Pieterpolini/opendbc/canduino/pcb/pcb_bottom_V002.png

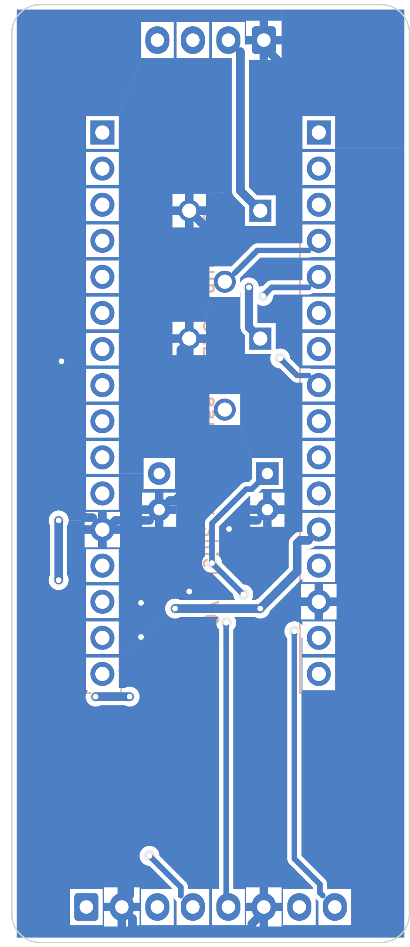
canduino/pcb/pcb_bottom_V002.png
