Pieterpolini/opendbc/canduino/pcb/pcb_bottom_V003.png

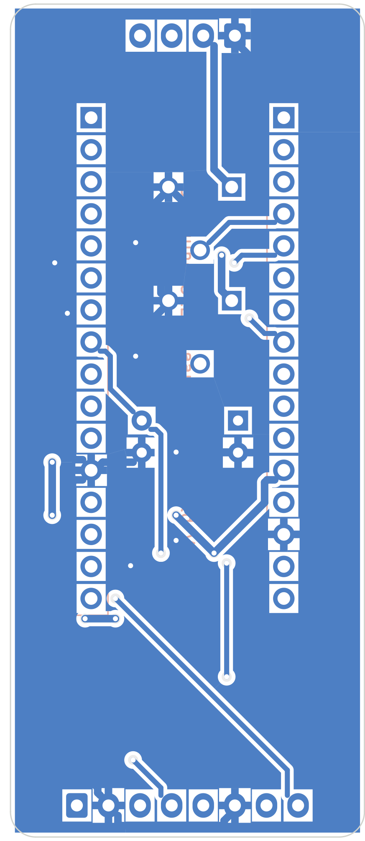
canduino/pcb/pcb_bottom_V003.png
