Pieterpolini/opendbc/canduino/pcb/pcb_top_V002.png

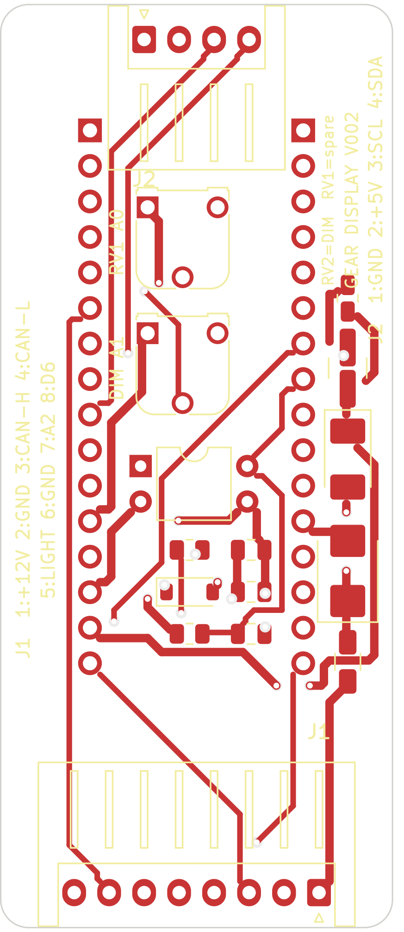
canduino/pcb/pcb_top_V002.png
