Pieterpolini/opendbc/canduino/pcb/pcb_top_V003.png

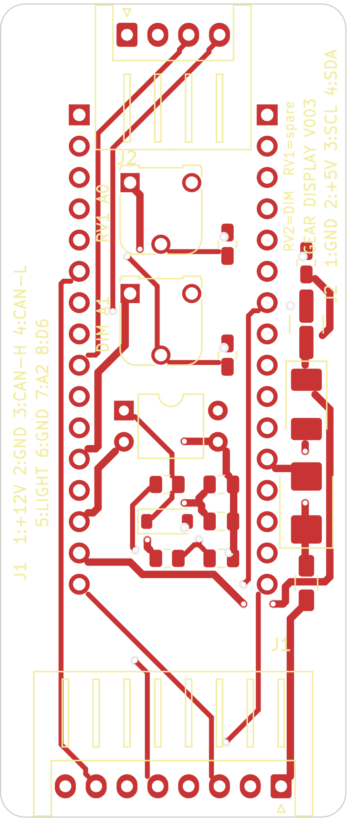
canduino/pcb/pcb_top_V003.png
