Pieterpolini/opendbc/canduino/pcb/pcb_top_V005.png

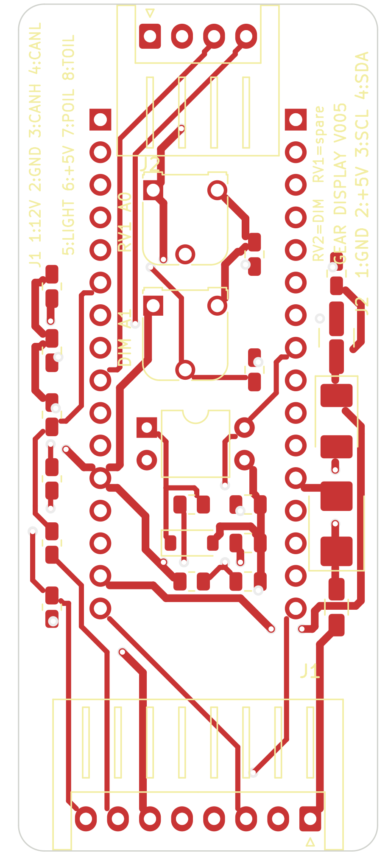
canduino/pcb/pcb_top_V005.png
