Pieterpolini/opendbc/canduino/pcb/pcb_top_V006.png

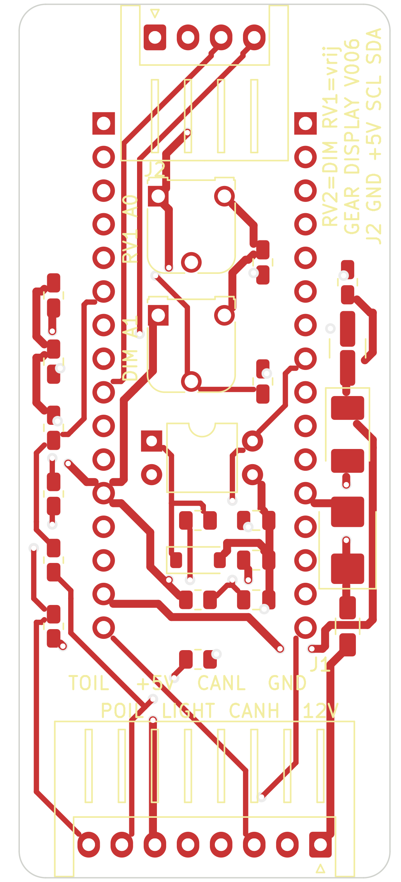
canduino/pcb/pcb_top_V006.png
