Pieterpolini/opendbc/canduino/pcb/bom_V006_jlc.csv

Comment | Designator | Footprint | LCSC Part #
3k3 | R1 | R_0805_2012Metric
10k | R2 | R_0805_2012Metric
1k8 | R3 | R_0805_2012Metric
4k7 | R4,R5 | R_0805_2012Metric
100k | R6 | R_0805_2012Metric
10uF/50V | C1 | C_1210_3225Metric
100nF/50V | C2 | C_0805_2012Metric
100nF | C3,C6,C7,C8,C9,C10 | C_0805_2012Metric
10uF | C4 | C_0805_2012Metric
1uF | C5 | C_0805_2012Metric
SS34 | D1 | D_SMA
SMBJ24A pin1=K | D2 | D_SMB
1N4148W | D3 | D_SOD-123
0.5A PTC | F1 | Fuse_1206_3216Metric
