Pieterpolini/opendbc/canduino/pcb/schematic_V006.pdf

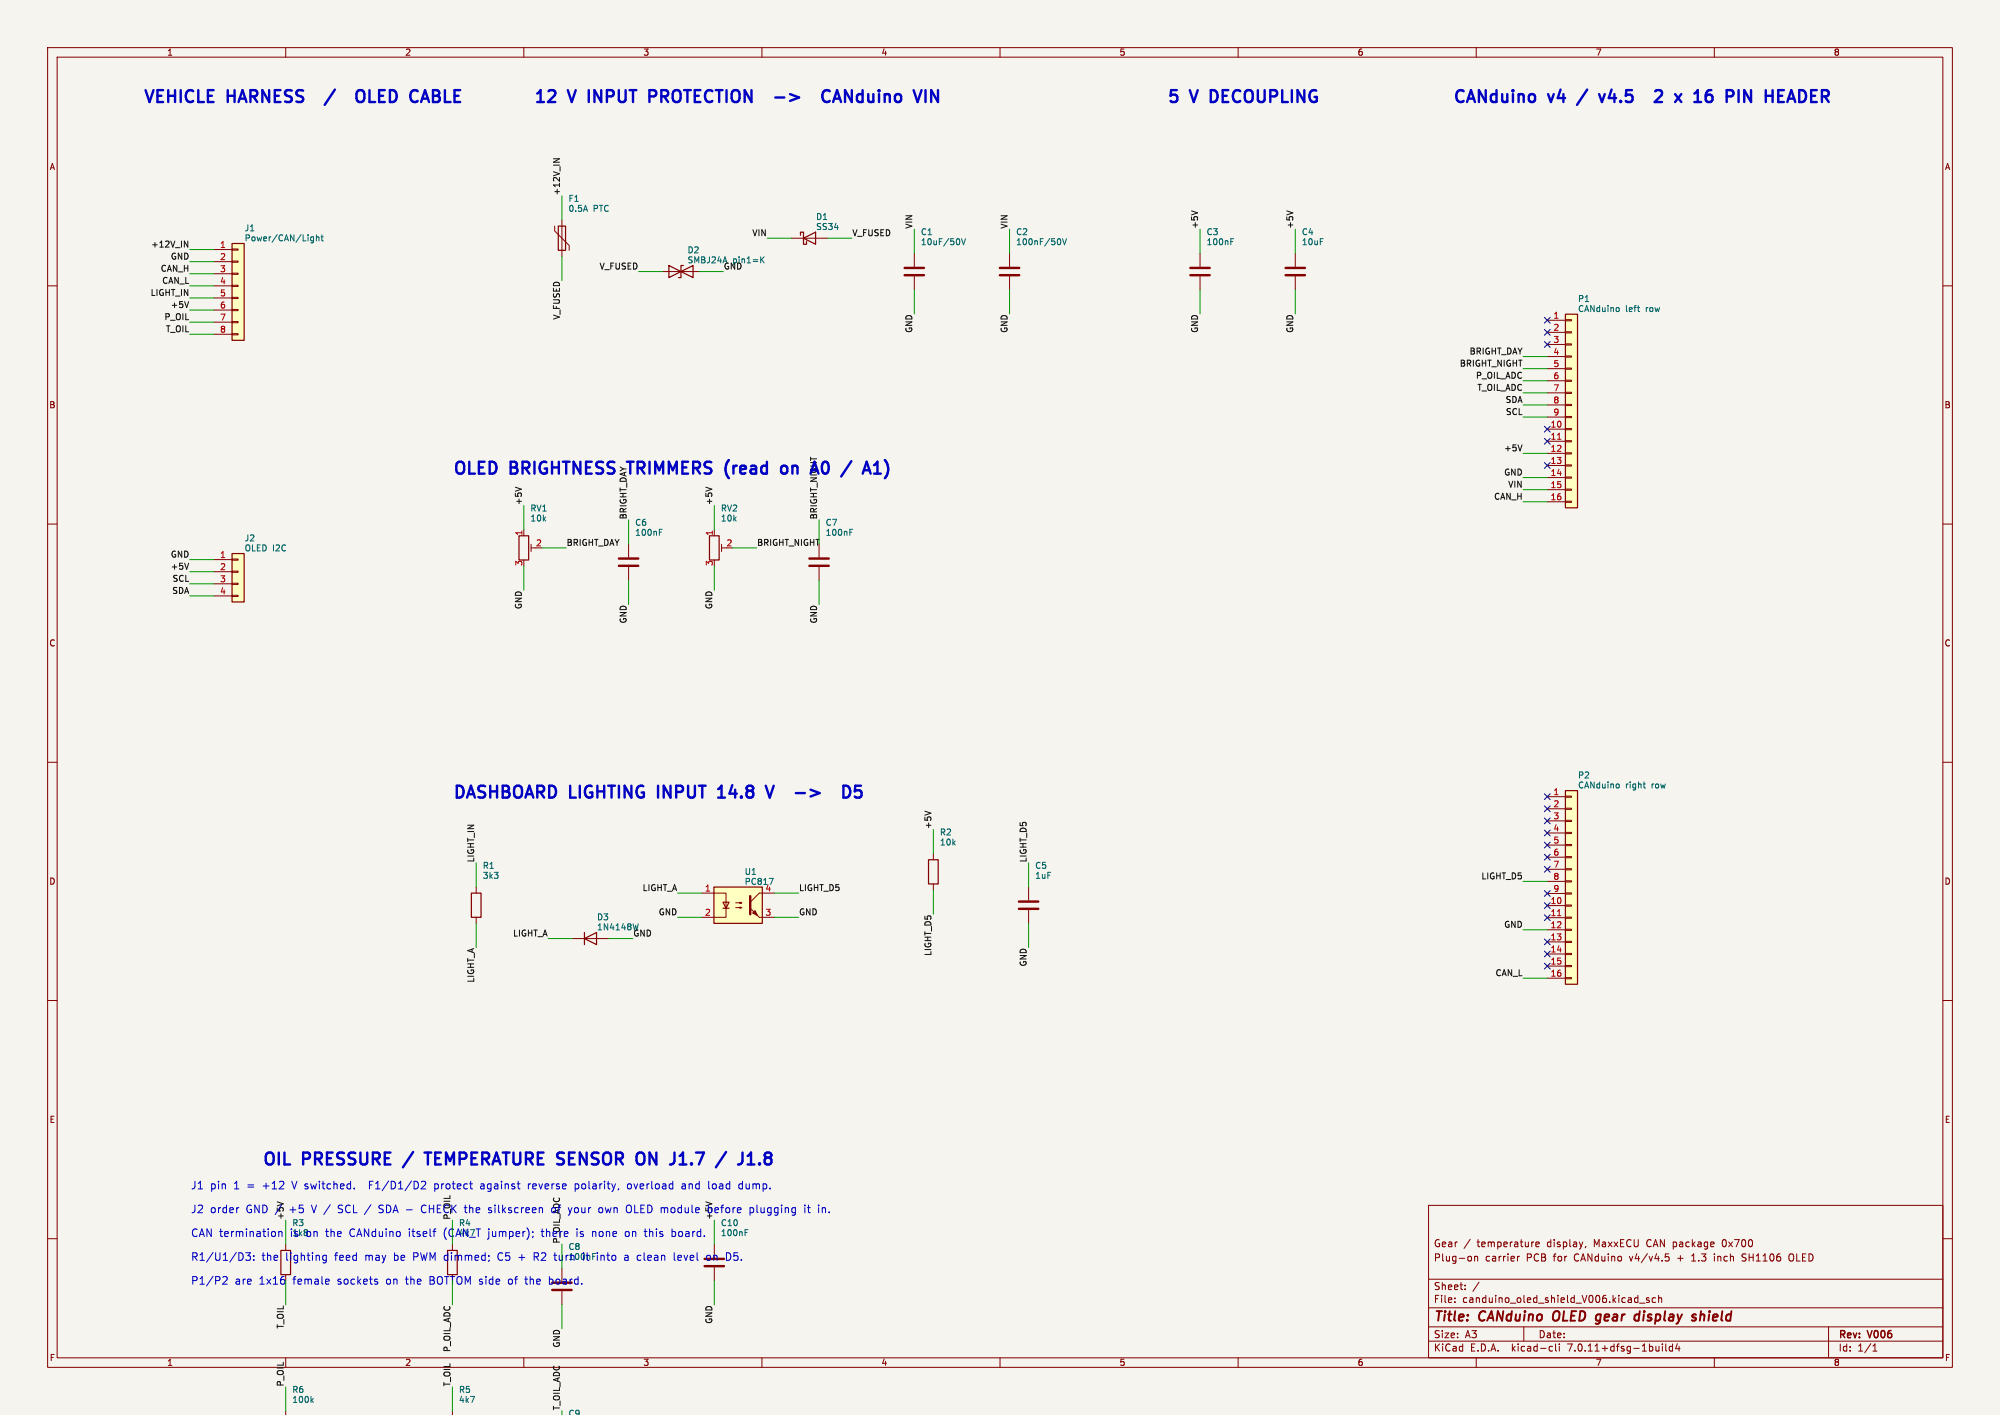
[picture p7: page 1]

OLED BRIGHTNESS TRIMMERS (read on A0 / A1)

OIL PRESSURE / TEMPERATURE SENSOR ON J1.7 / J1.8

Id: 1/1 Title: CANduino OLED gear display shield
