Pieterpolini/opendbc/canduino/pcb/pcb_bottom_V006.pdf

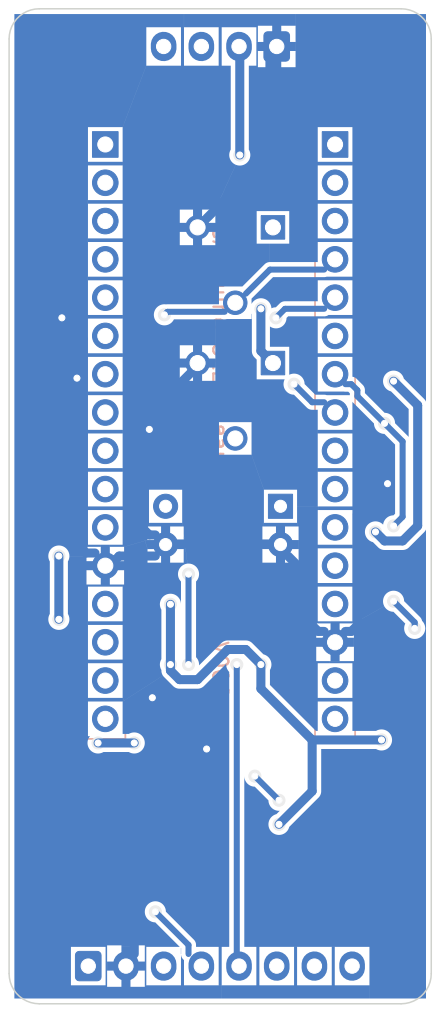
[picture p8: page 1]

CANduino OLED gear display shield V006
