Pieterpolini/opendbc/canduino/pcb/pcb_assembly_V006.pdf

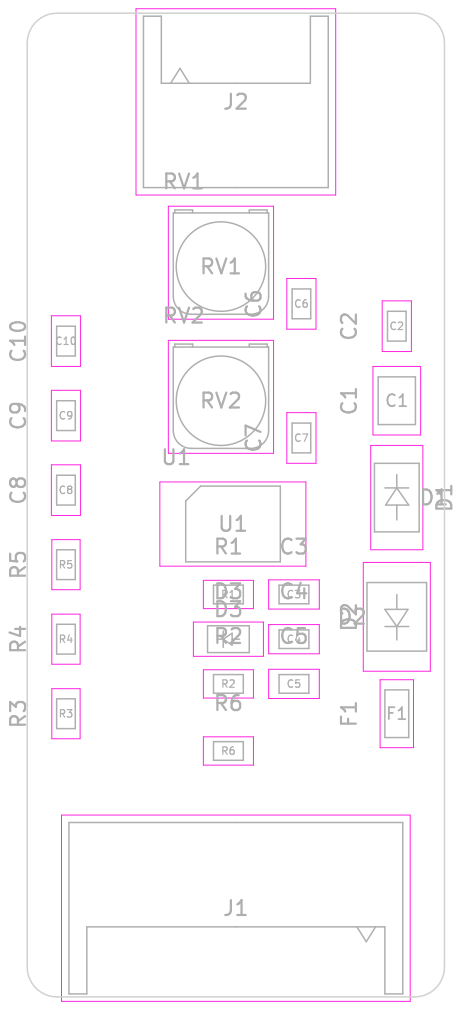
[picture p9: page 1]
