Pieterpolini/opendbc/canduino/pcb/pcb_top_V006.pdf

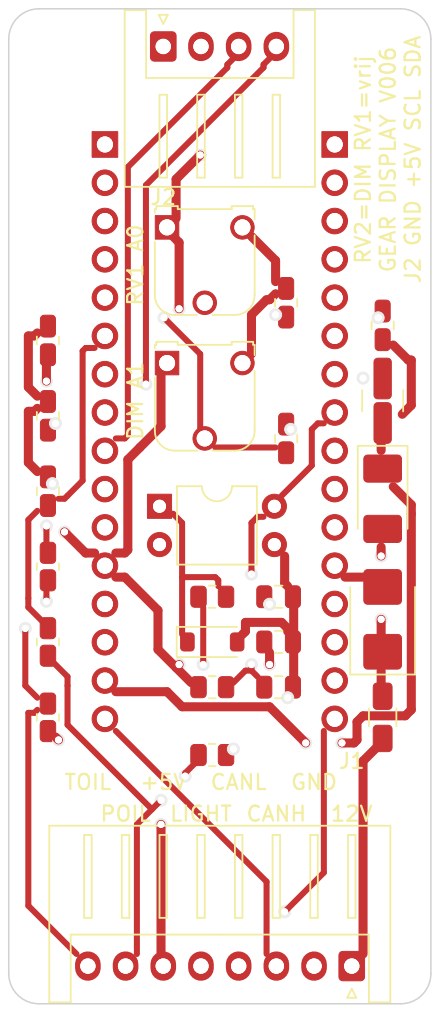
[picture p10: page 1]
