Pieterpolini/opendbc/canduino/pcb/schematic_V003.pdf

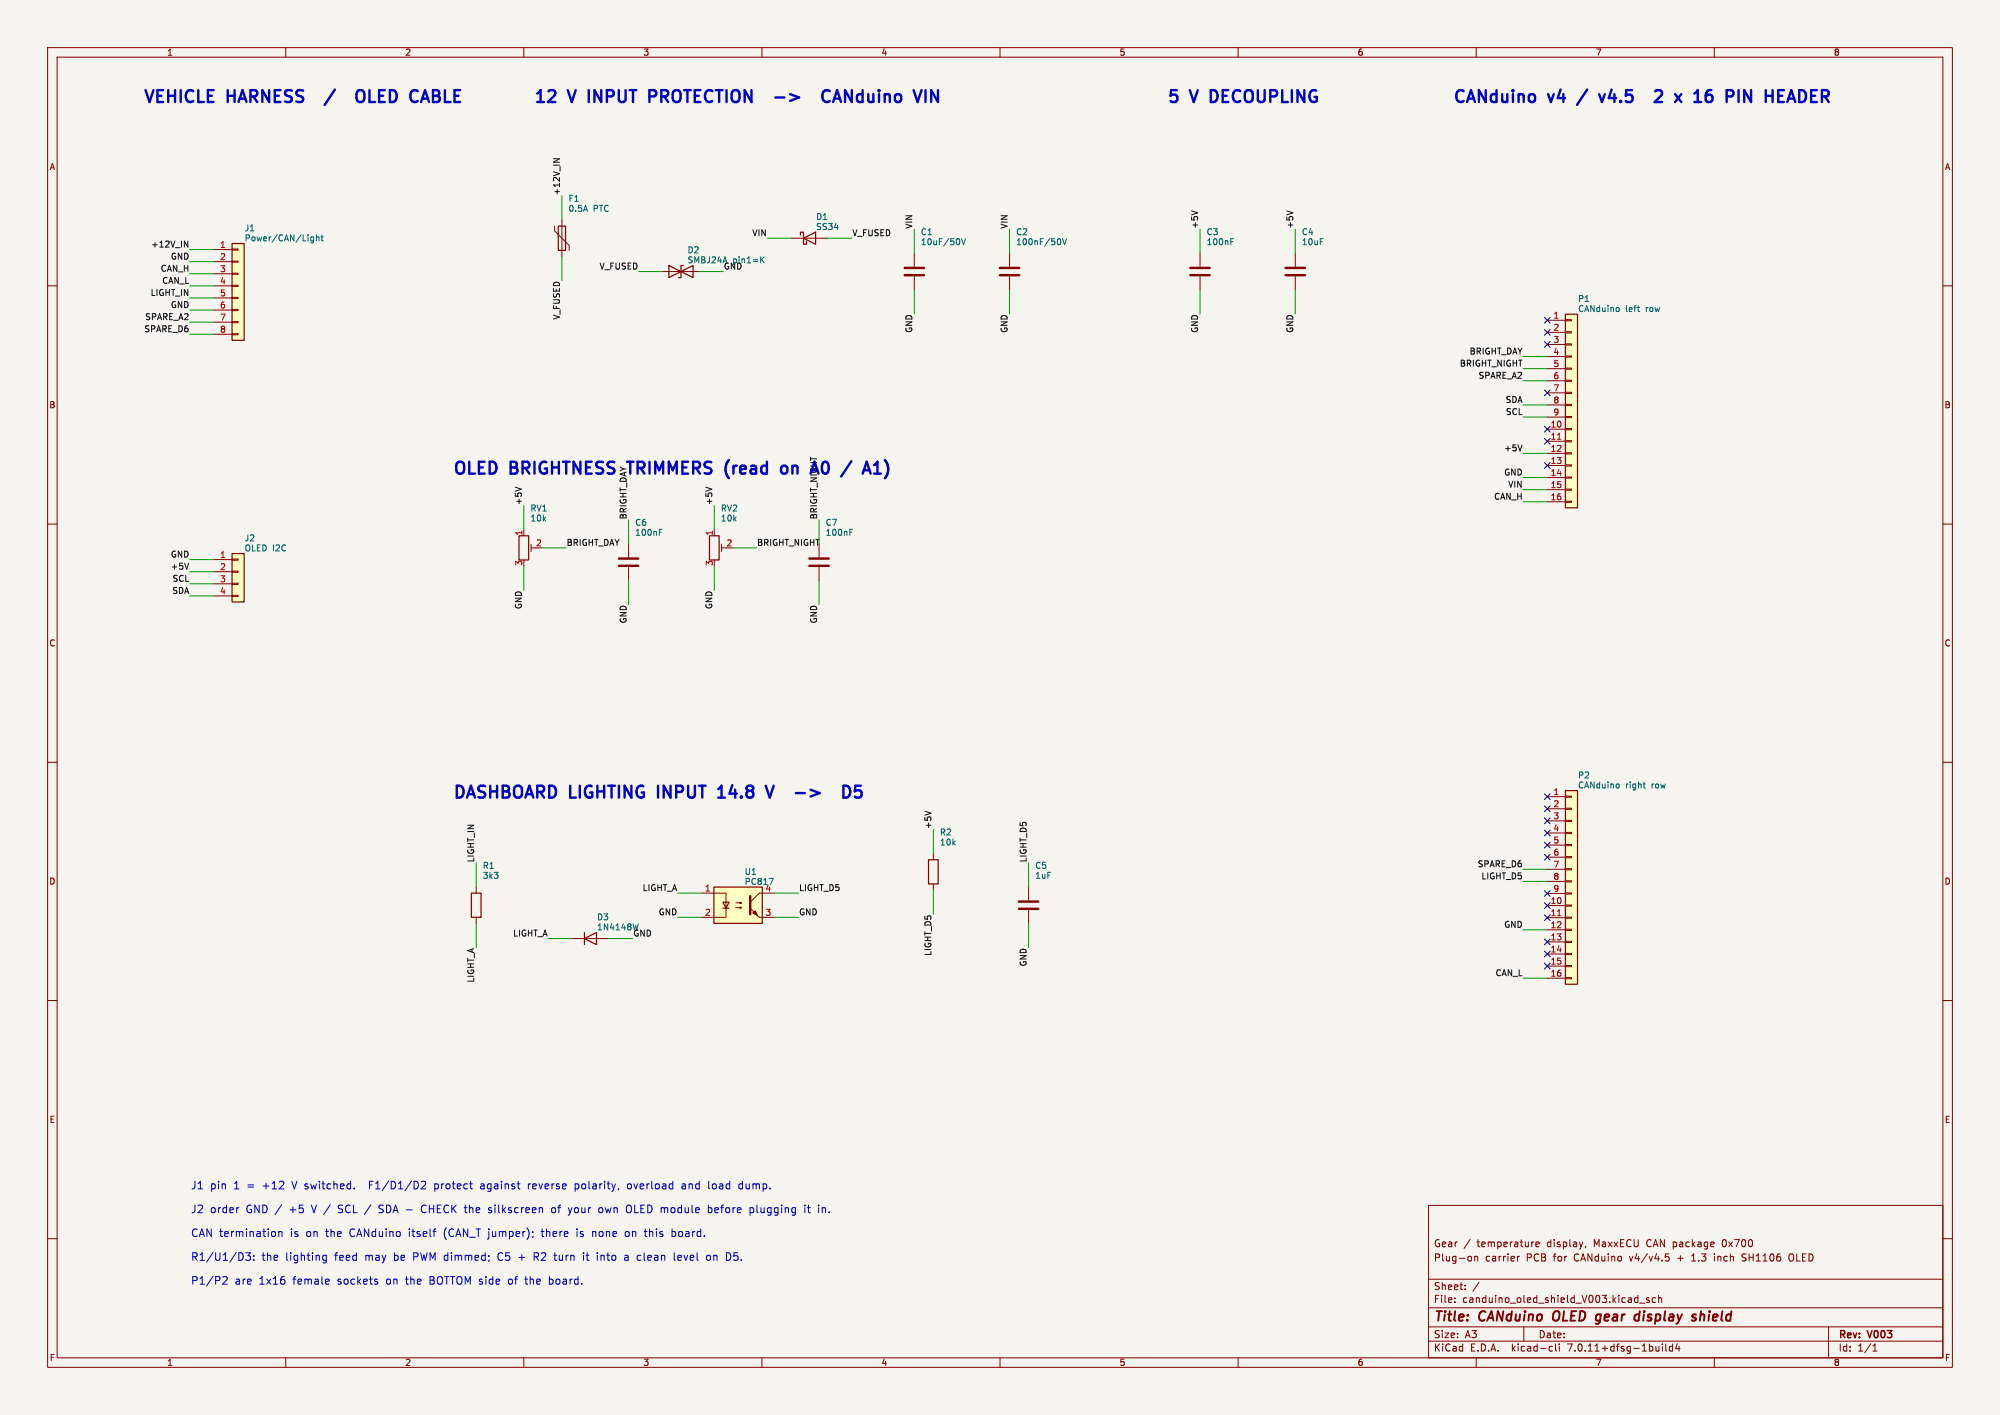
[picture p13: page 1]

OLED BRIGHTNESS TRIMMERS (read on A0 / A1)

Id: 1/1 Title: CANduino OLED gear display shield
