Pieterpolini/opendbc/canduino/pcb/pcb_bottom_V005.pdf

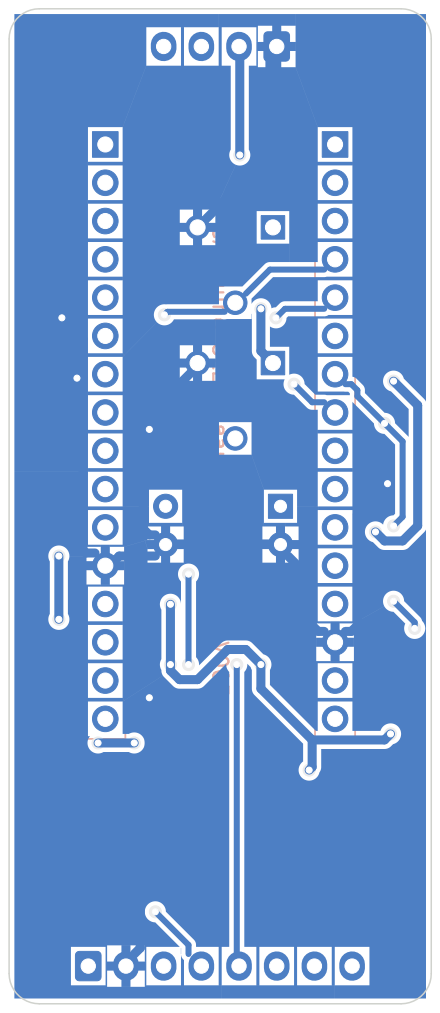
[picture p14: page 1]

CANduino OLED gear display shield V005
