Pieterpolini/opendbc/canduino/pcb/pcb_top_V005.pdf

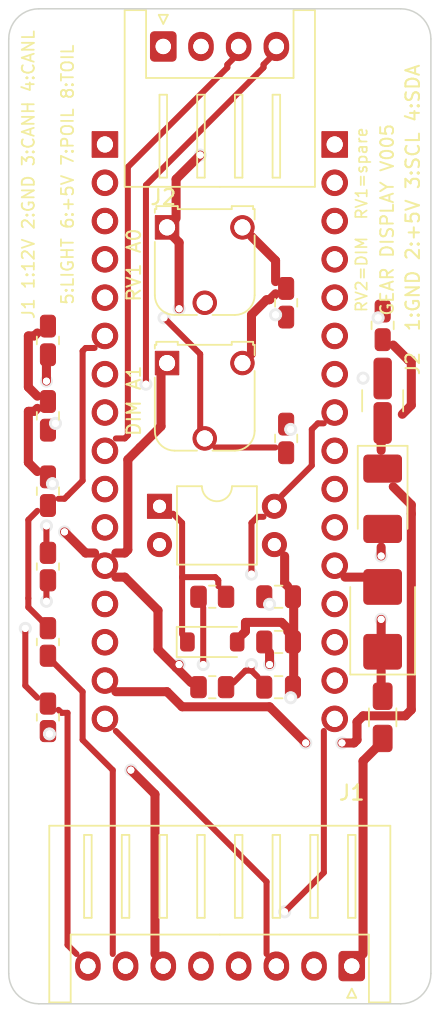
[picture p15: page 1]

J1 1:12V 2:GND 3:CANH 4:CANL 5:LIGHT 6:+5V 7:POIL 8:TOIL J2 1:GND 2:+5V 3:SCL 4:SDA RV2=DIM RV1=spare GEAR DISPLAY V005 RV1 A0 DIM A1
