Pieterpolini/opendbc/canduino/pcb/pcb_bottom_V004.pdf

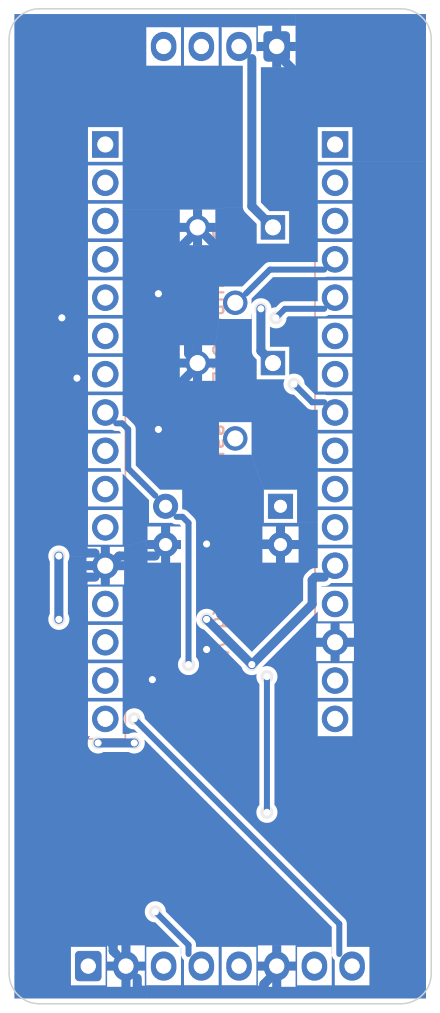
[picture p16: page 1]

CANduino OLED gear display shield V004
