Pieterpolini/opendbc/canduino/pcb/pcb_top_V004.pdf

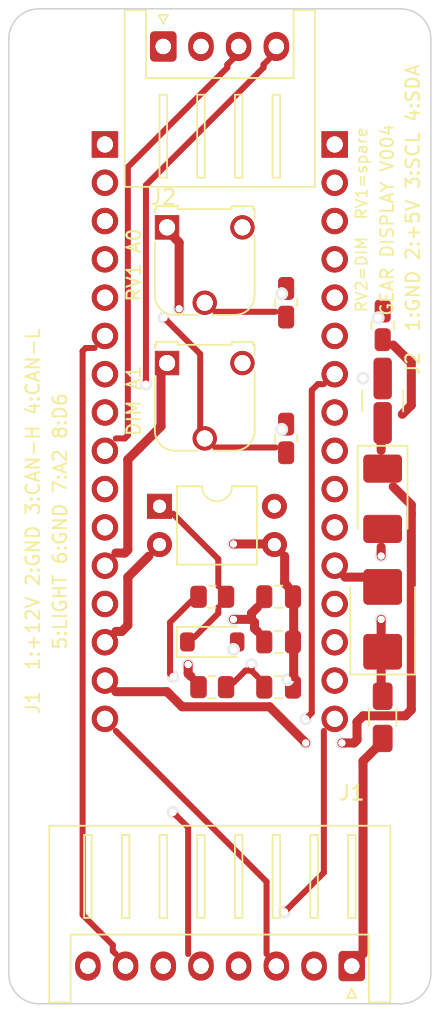
[picture p17: page 1]

J1 1:+12V 2:GND 3:CAN-H 4:CAN-L 5:LIGHT 6:GND 7:A2 8:D6 J2 1:GND 2:+5V 3:SCL 4:SDA RV2=DIM RV1=spare GEAR DISPLAY V004 RV1 A0 DIM A1
