Pieterpolini/opendbc/canduino/pcb/pcb_bottom_V003.pdf

CANduino OLED gear display shield V003
