Pieterpolini/opendbc/canduino/pcb/pcb_bottom_V002.pdf

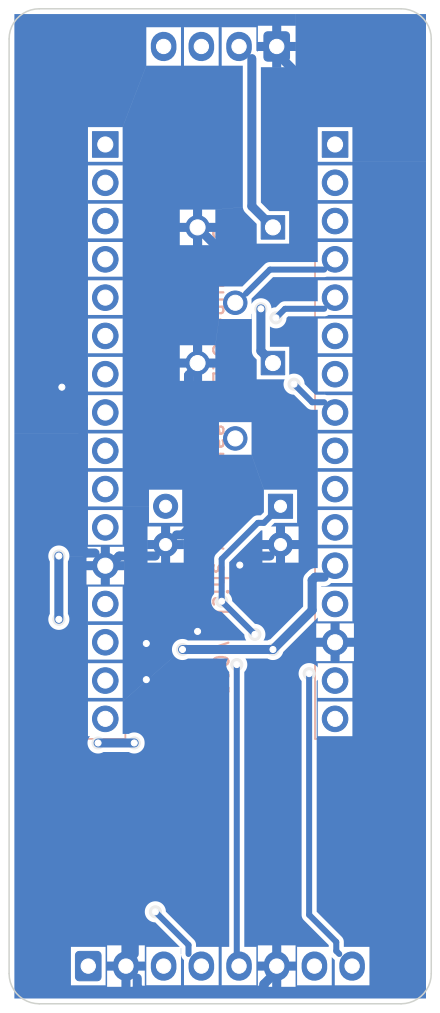
[picture p18: page 1]

CANduino OLED gear display shield V002
