Pieterpolini/opendbc/canduino/pcb/pcb_assembly_V005.pdf

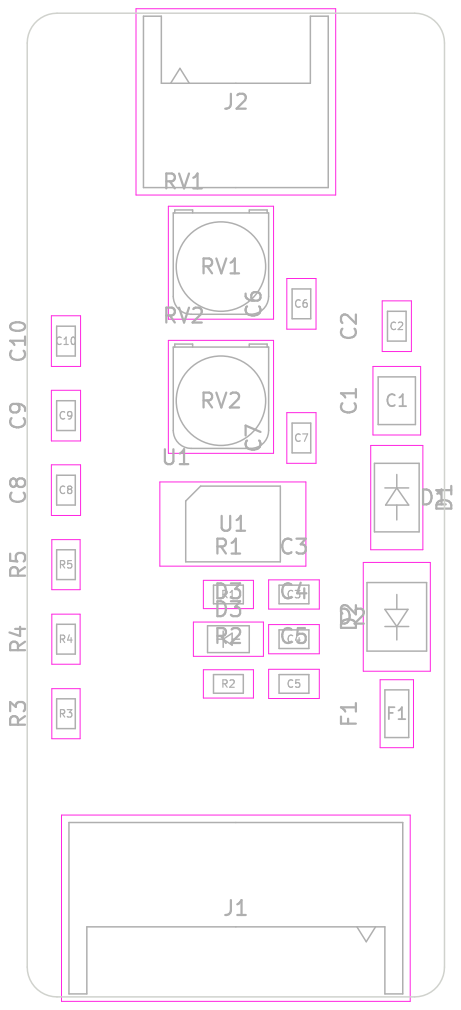
[picture p19: page 1]
