Pieterpolini/opendbc/canduino/pcb/pcb_assembly_V004.pdf

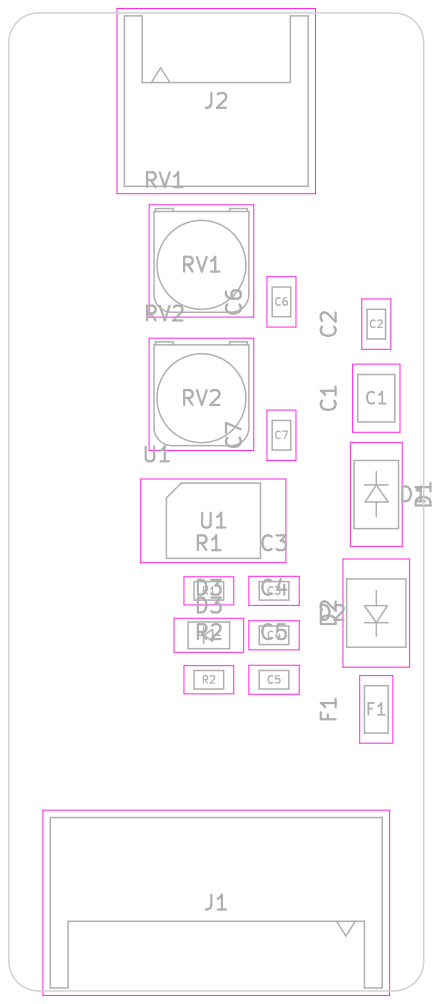
[picture p20: page 1]
