Pieterpolini/opendbc/canduino/pcb/pcb_assembly_V002.pdf

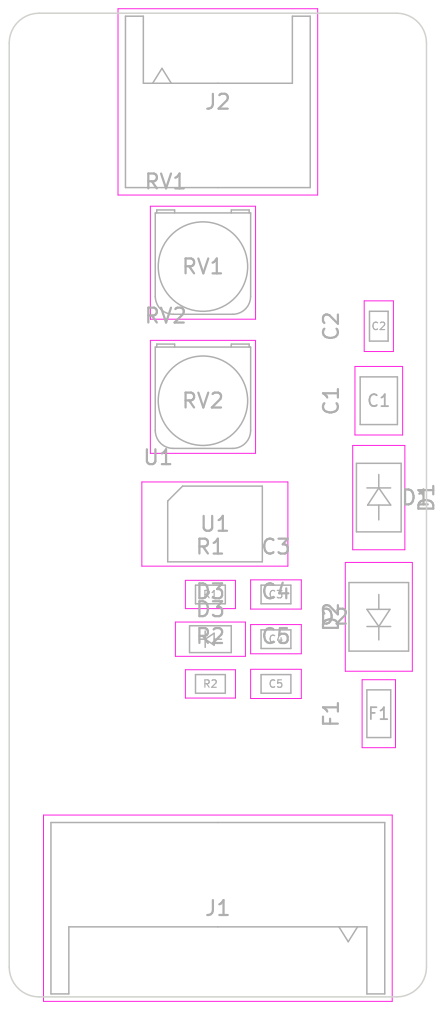
[picture p21: page 1]
