Pieterpolini/opendbc/canduino/pcb/canduino_oled_shield_V006.kicad_pcb

## KiCad design canduino/pcb/canduino_oled_shield_V006.kicad_pcb (2026-11-10)

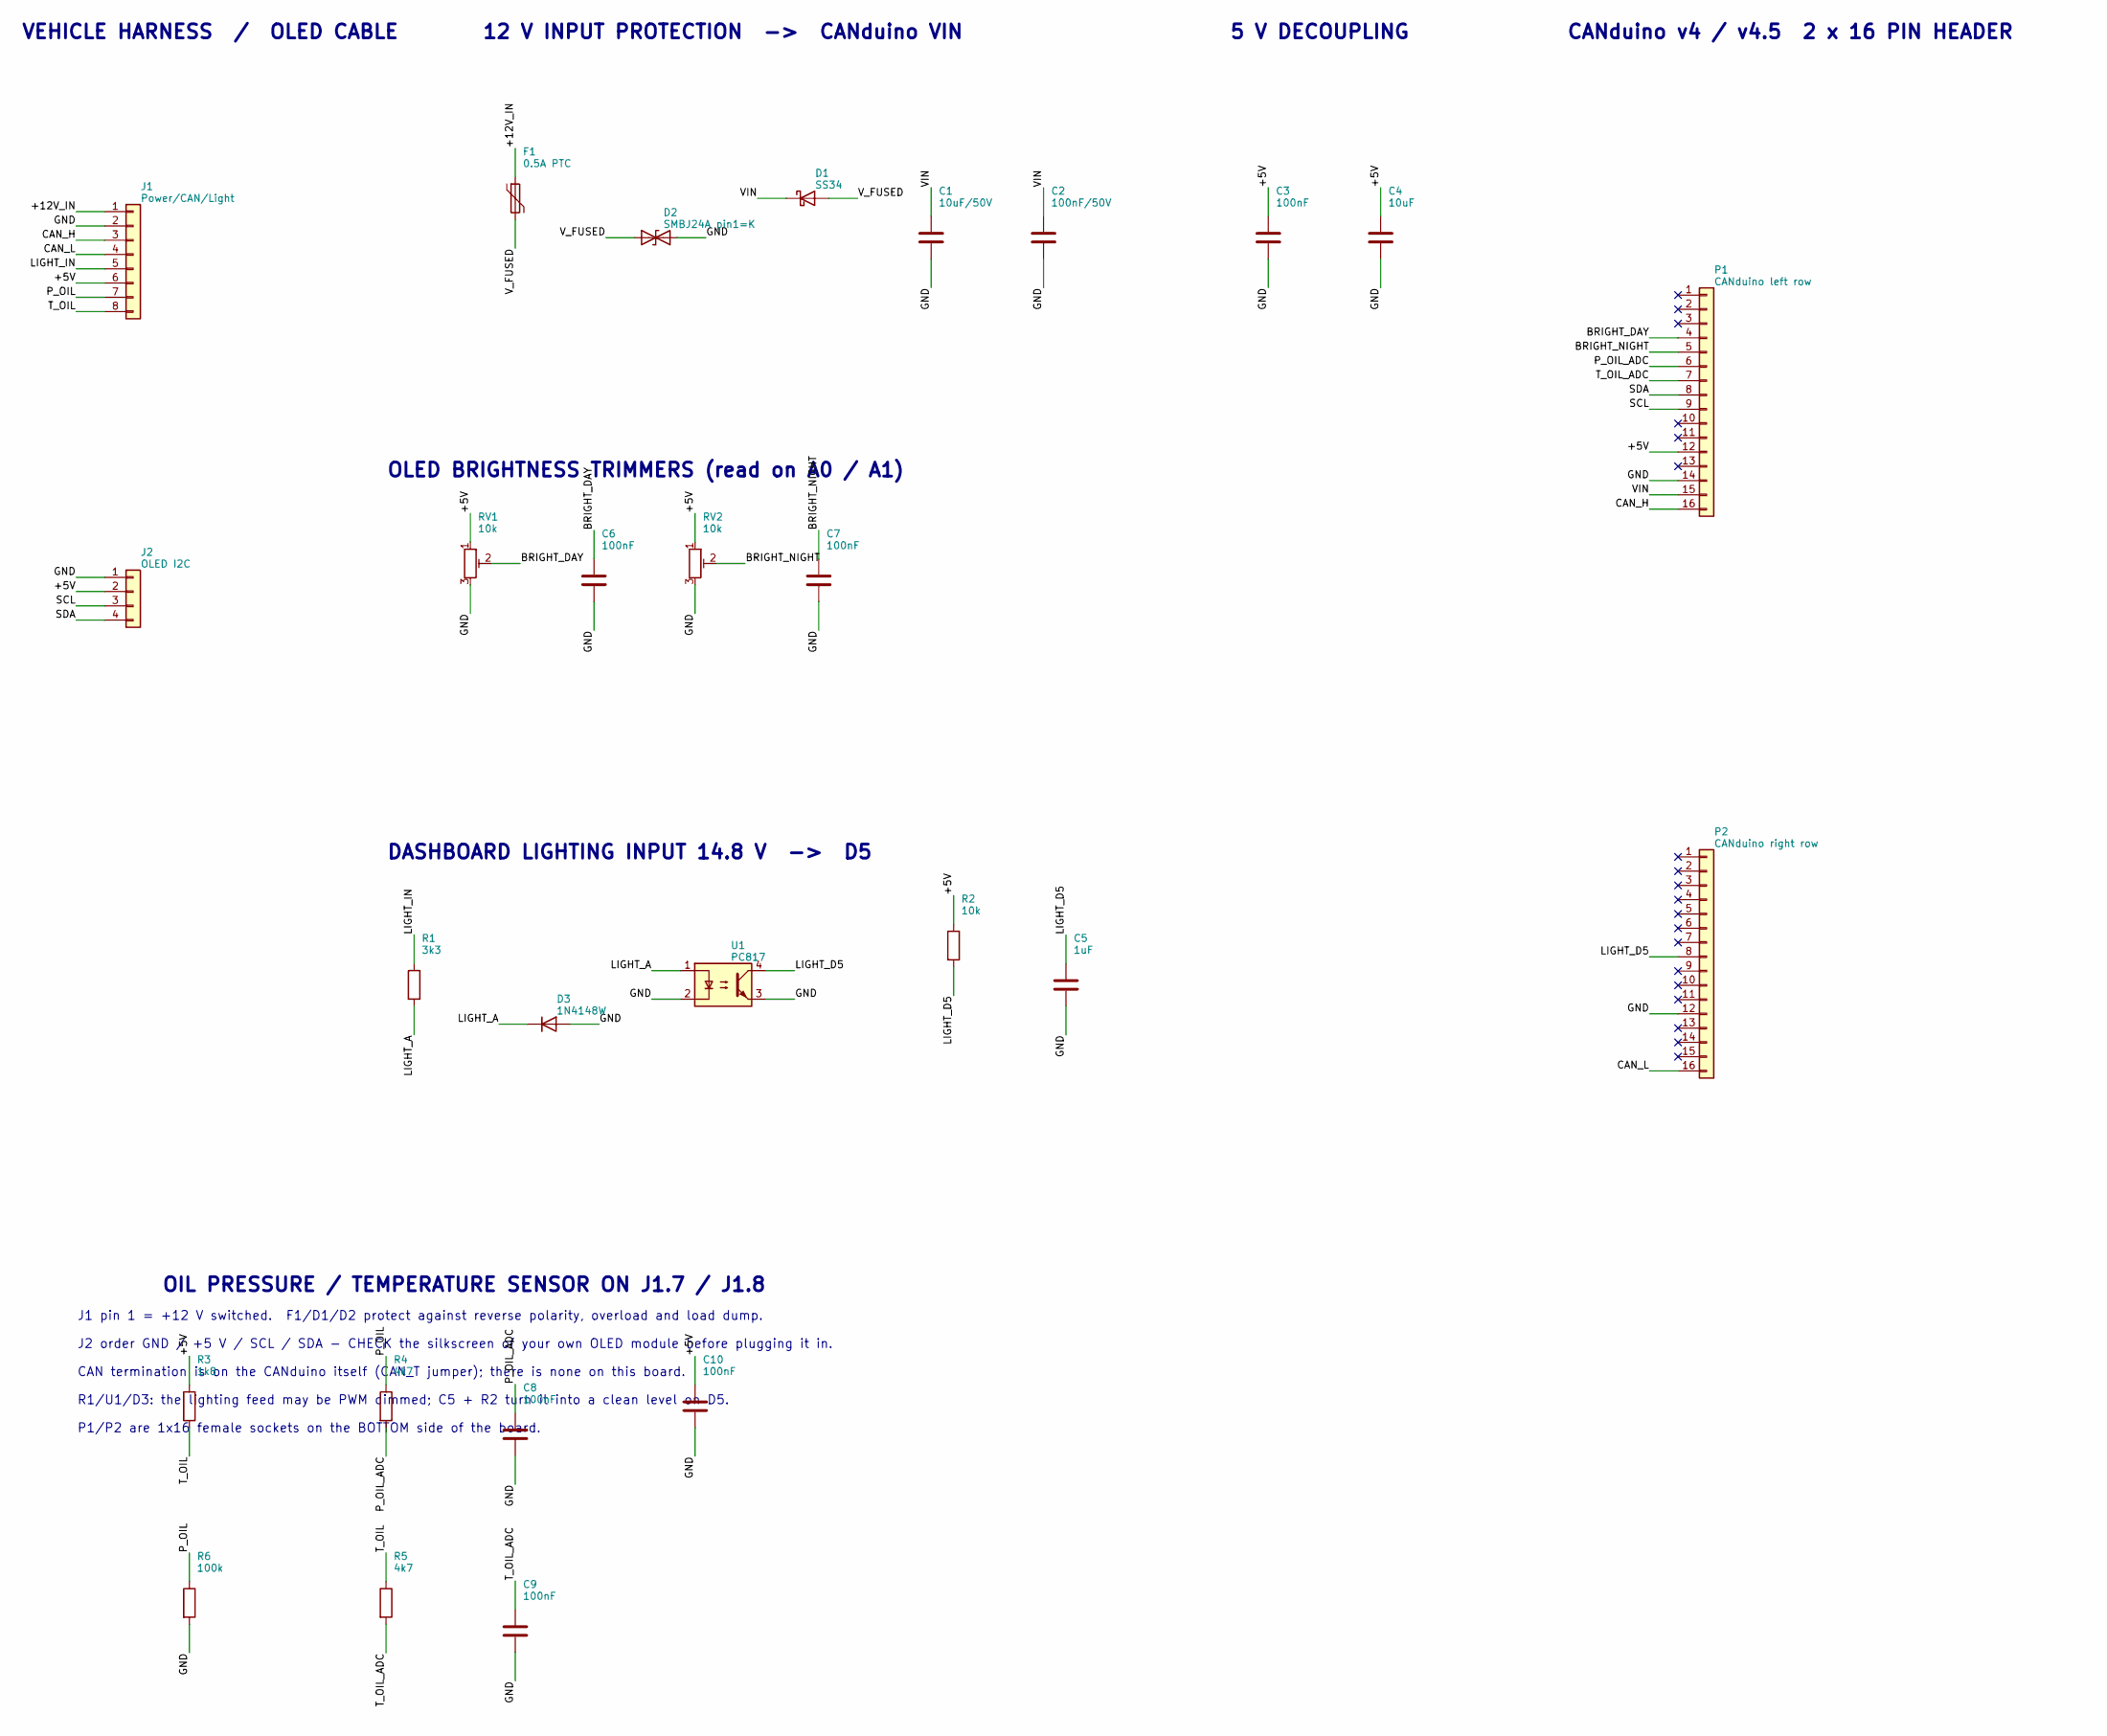
[picture p22: schematic canduino_oled_shield_V006.kicad_sch, CANduino OLED gear display shield]

Parts:
C1: 10uF/50V; C_1210_3225Metric
C2: 100nF/50V; C_0805_2012Metric
C3, C6, C7, C8, C9, C10: 100nF; C_0805_2012Metric
C4: 10uF; C_0805_2012Metric
C5: 1uF; C_0805_2012Metric
D1: SS34; D_SMA
D2: SMBJ24A pin1=K; D_SMB
D3: 1N4148W; D_SOD-123
F1: 0.5A PTC; Fuse_1206_3216Metric
J1: Power/CAN/Light; JST_XH_S8B-XH-A_1x08_P2.50mm_Horizontal
J2: OLED I2C; JST_XH_S4B-XH-A_1x04_P2.50mm_Horizontal
P1: CANduino left row; PinSocket_1x16_P2.54mm_Vertical
P2: CANduino right row; PinSocket_1x16_P2.54mm_Vertical
R1: 3k3; R_0805_2012Metric
R2: 10k; R_0805_2012Metric
R3: 1k8; R_0805_2012Metric
R4, R5: 4k7; R_0805_2012Metric
R6: 100k; R_0805_2012Metric
RV1, RV2: 10k; Potentiometer_Runtron_RM-065_Vertical
U1: PC817; DIP-4_W7.62mm

Connections:
+5V: C3.1, C4.1, C10.1, J1.6, J2.2, P1.12, R2.1, R3.1, RV1.1, RV2.1
+12V_IN: F1.1, J1.1
BRIGHT_DAY: C6.1, P1.4, RV1.2
BRIGHT_NIGHT: C7.1, P1.5, RV2.2
CAN_H: J1.3, P1.16
CAN_L: J1.4, P2.16
GND: C1.2, C2.2, C3.2, C4.2, C5.2, C6.2, C7.2, C8.2, C9.2, C10.2, D2.2 (A2), D3.2 (A), J1.2, J2.1, P1.14, P2.12, R6.2, RV1.3, RV2.3, U1.2, U1.3
LIGHT_A: D3.1 (K), R1.2, U1.1
LIGHT_D5: C5.1, P2.8, R2.2, U1.4
LIGHT_IN: J1.5, R1.1
P_OIL: J1.7, R4.1, R6.1
P_OIL_ADC: C8.1, P1.6, R4.2
SCL: J2.3, P1.9
SDA: J2.4, P1.8
T_OIL: J1.8, R3.2, R5.1
T_OIL_ADC: C9.1, P1.7, R5.2
VIN: C1.1, C2.1, D1.1 (K), P1.15
V_FUSED: D1.2 (A), D2.1 (A1), F1.2

Notes on the sheet:
VEHICLE HARNESS / OLED CABLE
12 V INPUT PROTECTION -> CANduino VIN
5 V DECOUPLING
OLED BRIGHTNESS TRIMMERS (read on A0 / A1)
DASHBOARD LIGHTING INPUT 14.8 V -> D5
OIL PRESSURE / TEMPERATURE SENSOR ON J1.7 / J1.8
CANduino v4 / v4.5 2 x 16 PIN HEADER
J1 pin 1 = +12 V switched. F1/D1/D2 protect against reverse polarity, overload and load dump.
J2 order GND / +5 V / SCL / SDA - CHECK the silkscreen of your own OLED module before plugging it in.
CAN termination is on the CANduino itself (CAN_T jumper); there is none on this board.
R1/U1/D3: the lighting feed may be PWM dimmed; C5 + R2 turn it into a clean level on D5.
P1/P2 are 1x16 female sockets on the BOTTOM side of the board.

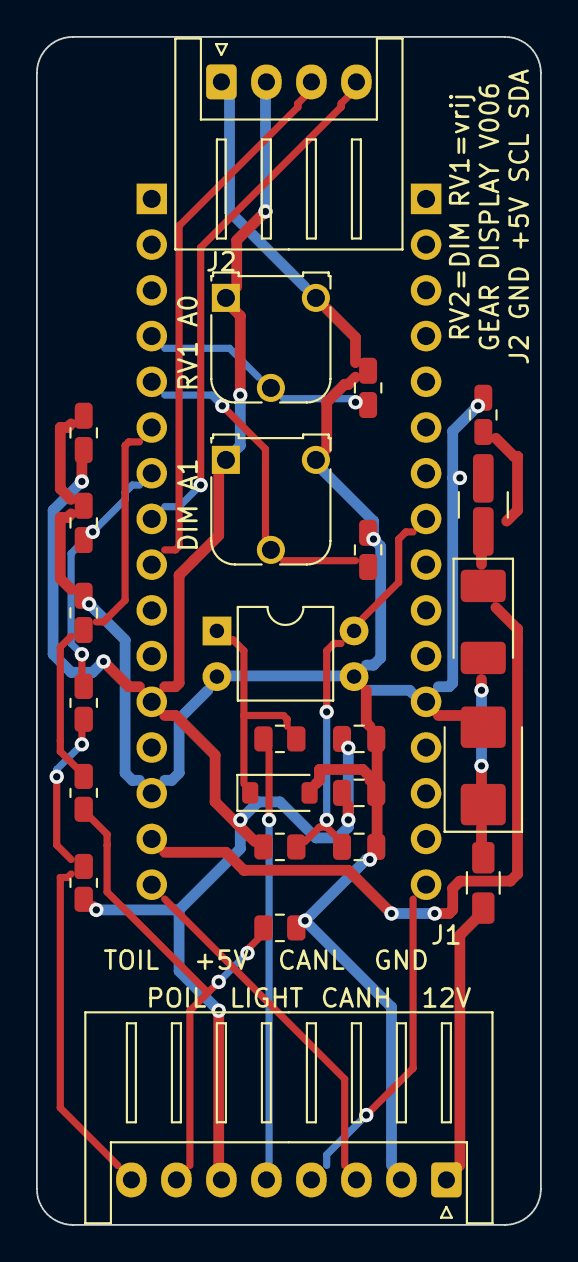
[picture p23: board canduino_oled_shield_V006.kicad_pcb from above]

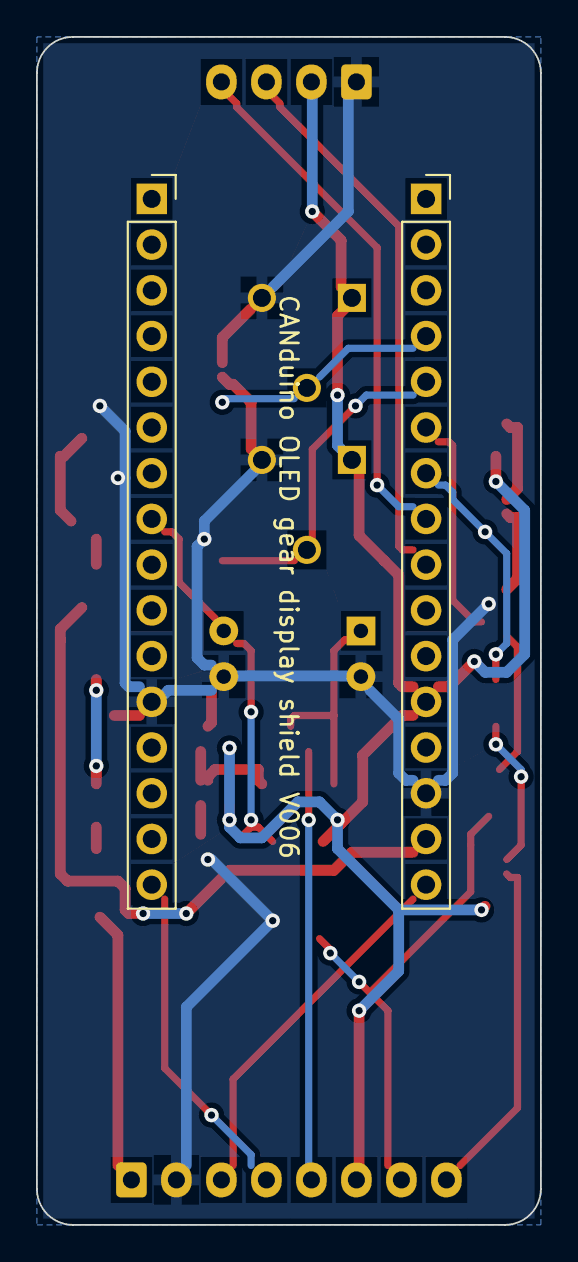
[picture p24: board canduino_oled_shield_V006.kicad_pcb from below]

Board: 2 copper layers, 28.0 x 66.0 mm, 27 parts (2 on the bottom side), 18 nets.
