Pieterpolini/opendbc/canduino/kcp_fonts.h

// Trimmed GFX fonts for the KCP gear display, made from Liberation Sans.
// Only the characters this display draws are included, so they cost about
// 3.9 kB of flash instead of the tens of kB a complete font would take.
// Always drawn with setTextSize(1), so nothing is pixel-doubled.

#ifndef KCP_FONTS_H
#define KCP_FONTS_H
#include <Adafruit_GFX.h>

// KcpGear - 45 px bold: 1-8, P R N D, dash
const uint8_t KcpGearB[] PROGMEM={
255,255,255,255,255,255,255,255,255,255,255,255,255,255,0,63,224,0,3,255,0,0,127,248,0,7,255,192,0,255,
254,0,15,255,240,1,255,255,128,31,255,252,0,255,63,224,7,241,255,0,62,15,248,1,224,127,192,12,3,254,
0,64,31,240,0,0,255,128,0,7,252,0,0,63,224,0,1,255,0,0,15,248,0,0,127,192,0,3,254,0,
0,31,240,0,0,255,128,0,7,252,0,0,63,224,0,1,255,0,0,15,248,0,0,127,192,0,3,254,0,0,
31,240,0,0,255,128,0,7,252,0,0,63,224,0,1,255,0,0,15,248,0,0,127,192,0,3,254,0,127,255,
255,255,255,255,255,255,255,255,255,255,255,255,255,255,255,255,255,255,255,254,0,63,240,0,7,255,248,0,63,255,
240,1,255,255,240,15,255,255,192,127,255,255,131,255,255,255,15,252,15,252,127,224,31,241,255,0,63,231,252,0,
255,159,224,3,254,255,128,15,248,0,0,63,224,0,0,255,128,0,3,252,0,0,31,240,0,0,255,192,0,7,
254,0,0,31,248,0,0,255,192,0,15,254,0,0,127,248,0,3,255,192,0,31,254,0,0,255,240,0,7,255,
0,0,63,248,0,1,255,192,0,15,254,0,0,127,240,0,3,255,0,0,31,248,0,0,127,192,0,3,255,0,
0,31,248,0,0,127,192,0,3,255,255,255,255,255,255,255,255,255,255,255,255,255,255,255,255,255,255,255,255,255,
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
{0,11,17,13,1,-17},{24,10,17,13,2,-17},{46,11,17,13,1,-17},{70,11,17,13,1,-17},{94,11,17,13,1,-17},{118,11,17,13,1,-17},{142,11,17,13,1,-17},
{166,11,17,13,1,-17},{190,11,17,13,1,-17},{214,11,17,13,1,-17},
};
const GFXfont KcpNum PROGMEM={(uint8_t*)KcpNumB,(GFXglyph*)KcpNumG,48,57,20};

#endif
