Pieterpolini/opendbc/(commit log)

2026-09-19 canduino: read gear display data from MaxxECU 0x700 package
    The MaxxECU "display" CAN package now sends everything in one standard
    frame on CAN 1: ID 0x700, little endian, 8 one-byte values at 50 Hz.
    Replace the old 0x702 (gear) and 0x705 (mode + temp) parsing with a
    single 0x700 handler using the configured byte order, and document the
    full byte map in the sketch.
    Claude-Session: https://claude.ai/code/session_01BrKsr32cz9JmXRCLyv5gMf
    [Geardisplay_SH1106_1_3_Inch_maxx_ecu_700_V000.ino]
2026-09-19 canduino: use documented MaxxECU value encodings for gear and drive mode
    Per the MaxxECU webhelp, gearbox mode is 0=Park, 1=Reverse, 2=Neutral,
    4=Drive, 8/16/32=Manual variants; VSS Gear reports 1..8 with -1 for
    reverse; drive mode is 1=STREET, 3=SPORT, 5=TRACK, 10=DRAG. Replace the
    guessed mappings with these and let the selector decide P/R/N.
    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
    [Geardisplay_SH1106_1_3_Inch_maxx_ecu_700_V001.ino]
2026-09-26 canduino: add KiCad shield PCB for CANduino + 1.3in SH1106 OLED
    Two-layer 28 x 62 mm plug-on carrier that sits on the CANduino's 2x16
    headers with 1x16 female sockets on the bottom side:
    - J1: 8-pin JST-XH right angle (12V, GND, CAN-H, CAN-L, dashboard
    lighting 14.8V, GND, spare A2, spare D6)
    - J2: 1x4 right-angle header for the OLED (GND / +5V / SCL / SDA)
    - 12V input protection: PTC fuse, 24V TVS, series Schottky, bulk and
    HF decoupling, feeding the CANduino VIN pin
    - Lighting input through a PC817 opto-coupler to D5, with pull-up and
    a filter capacitor for PWM-dimmed feeds
    - Two 10k trimmers on A0/A1 for the two OLED brightness levels
    (SH1106 brightness is the 0x81 contrast regis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
    [bom_V000.csv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]
2026-09-27 canduino: confirm v4.5 pinout, rework brightness to one dim trimmer
    The official CANduino v4.5 drawing turns out to have exactly the same
    2x16 pin arrangement as the v4, so the shield's pin mapping needed no
    change. Board revised to V001 for the brightness rework only.
    Brightness behaviour is now:
    lighting input 0 V -> D5 high -> full brightness, fixed at 255
    lighting input >=12 V -> D5 low -> dimmed, level set by RV2 on A1
    RV1 on A0 becomes a spare; the silkscreen is relabelled RV1/DIM and the
    trimmer legend updated. No copper changed, DRC still clean.
    Sketch V013 adds the brightness control: a contrast helper writing the
    SH1106 0x81 register, a 300 ms debounce on D5, a 200 ms u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
    [bom_V000.csv, bom_V001.csv, canduino_oled_shield_V000.kicad_pcb, canduino_oled_shield_V000.kicad_sch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]
2026-09-27 canduino: hold the light input high with INPUT_PULLUP in V013
    Without the shield fitted D5 would float, so the display could drop to
    the dim level at random. The internal pull-up keeps it high, which means
    V013 also runs unchanged on a bare Canduino at full brightness; with the
    shield the external 10k dominates and the opto still pulls the pin low.
    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
2026-09-27 canduino/pcb: add ready-to-order gerber zip and full project zip
    Both are duplicates of files already in the tree, but having them as a
    single download makes ordering and archiving one click instead of
    assembling the folder by hand.
    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
2026-09-27 canduino/pcb: V002 - latched, keyed JST XH connector for the OLED
    A plain 2.54 mm header has no lock and no key, so the display cable can
    vibrate loose and fits both ways round. J2 becomes a JST XH 4-pin
    right-angle (S4B-XH-A): same family as J1, so one crimp tool and one
    contact type for the whole board, and ready-made XH 4-pin cables are
    easy to get. An XH header also drops into the OLED module's 2.54 mm
    holes - 7.50 mm pin span against 7.62 mm, which four 1.0 mm holes
    absorb - so both ends stay pluggable.
    The XH housing needs 9.7 mm of board depth behind its pads, so the board
    grows from 62 to 66 mm and the trimmers, opto and passives shift down.
    Copper is otherwise unchanged: 149 tracks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
    [bom_V001.csv, bom_V002.csv, canduino_oled_shield_V001.kicad_pcb, canduino_oled_shield_V001.kicad_sch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]
2026-09-27 canduino/pcb: correct V002 README rows that still described V001
    Board size, via count, the J2 connector row, the cable text and the
    firmware line number were left over from V001 because the replacements
    matched on ASCII dashes while the file uses typographic ones.
    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
2026-11-05 canduino: V003 board with wiper filters, V014 firmware with CAN brightness
    Board: C6 and C7, 100 nF from each trimmer wiper to ground. A 10 k pot
    presents at most 2.5 k source impedance, so the filter settles in about
    0.25 ms against a 200 ms update interval - fast enough to be invisible,
    slow enough to swallow noise picked up in the car. Nothing else moved:
    same outline, same connectors, 0 clearance violations.
    Firmware: byte 6 of the 0x700 package was a fixed 0 and now carries a
    brightness command, so no new CAN ID and no extra MaxxECU package is
    needed. 0 = auto (the D5 lighting input decides, as before), 1 = panel
    off, 2 = force full, 3 = force the dimmed trimmer level, 4..255 = use
    the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
2026-11-09 canduino: byte 6 becomes a dim percentage, 0 = full (V015 / board V004)
    The command-code scheme V014 used had 0 mean "auto", which is wrong for
    how this is actually driven: MaxxECU sends a fixed 0 until the byte is
    configured, and a byte that goes missing reads as 0 too. Byte 6 is now a
    straight dim percentage instead - 0 = full brightness, 100 = dimmed down
    to the floor trimmer RV2 is set to, 255 still blanks the panel. The
    failure mode is now a bright screen rather than a dark one.
    RV2 keeps a job: it sets how dark 100 % is, adjustable in the car without
    a laptop. The D5 lighting input drops to backup duty and only decides
    while no 0x700 frame has arrived for 3 s.
    Board V004 is byte-for-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
2026-11-10 canduino/pcb: V005 - J1 spares become oil pressure and temperature inputs
    The lighting input does not need its own ground return, so J1 pin 6 is
    free. That is the pin this needed: the sensor wants a 5 V supply, and
    without it a 4-wire sensor could not be fed from J1 at all.
    New J1: 6 = +5 V to the sensor, 7 = oil pressure, 8 = oil temperature.
    The old pin 8 went to D6, which has no ADC on the ATmega328P, so the
    temperature channel moves to A3 (left row pin 7). Pressure stays on A2.
    D6 is now unconnected.
    Six parts added in the left edge strip, which was empty:
    - R3 2k2 pull-up for the sensor's NTC. The value is the geometric mean
    of the NTC resistance at -40 C and +130 C, which centres t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
2026-11-10 canduino: V006 board, V017 firmware, and real AVR build figures
    Sensor data arrived, so the placeholder values are now computed from it.
    From 44864 ohm at -40 C and 72 ohm at +140 C the NTC works out at
    B = 3444 K, R25 = 1793 ohm. The geometric mean of the two end
    resistances is 1797 ohm, so R3 goes from the 2k2 placeholder to 1k8,
    which is the pull-up that centres the divider over the whole range.
    Worst resolution is 0.76 counts/C at 140 C and self-heating peaks at
    0.51 mW. Pressure is 0.5-4.5 V over 0-10 bar, ratiometric against the
    same 5 V the ADC references, so bar = (ADC - 102.3) / 81.84.
    R6 (100k) added as a pull-down on the pressure line: a broken wire now
    reads zero instead of floa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
2026-11-10 canduino/pcb: label each J1 pin over its own hole
    A list along the board edge means counting holes with the connector in
    the way. Each pin now carries its own label in the free band between the
    passives and the housing, staggered over two rows so 2.5 mm pitch has
    room: odd pins on the upper row, even pins on the lower. The reference
    designator moved clear of them. Copper untouched, DRC still clean.
    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
